bwyogatama/DC-Motor-Positioning-Control-System-Using-Arduino-Microcontroller/Schematic.png

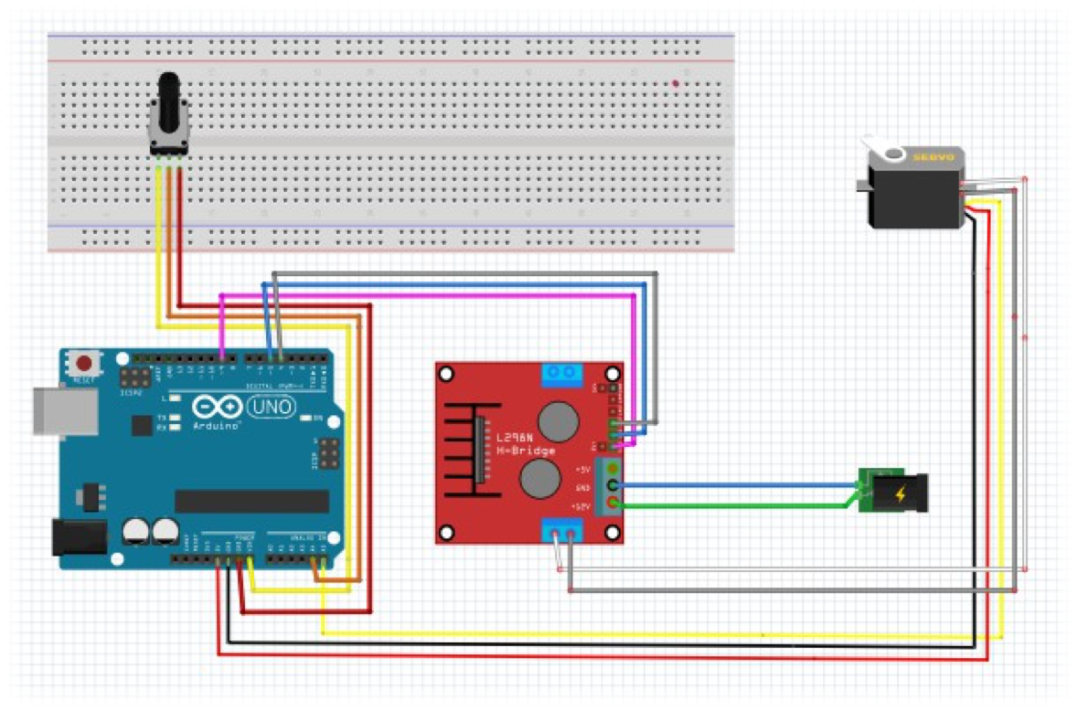
Schematic.png
