bwyogatama/DC-Motor-Positioning-Control-System-Using-Arduino-Microcontroller/Implementation1.png

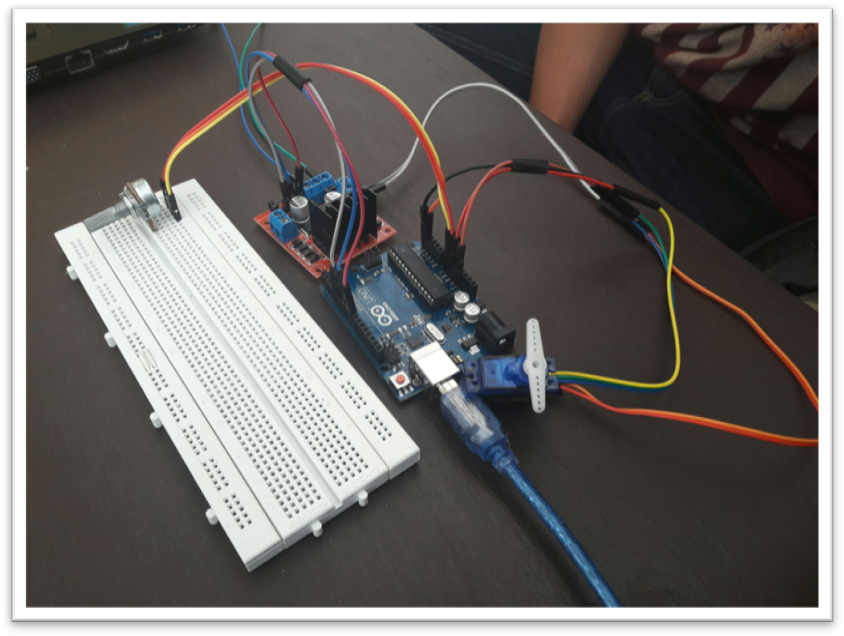
Implementation1.png
