bwyogatama/DC-Motor-Positioning-Control-System-Using-Arduino-Microcontroller/README.md

# DC-Motor-Positioning-Control-System-Using-Arduino-Microcontroller
