bwyogatama/DC-Motor-Positioning-Control-System-Using-Arduino-Microcontroller/Implementation2.png

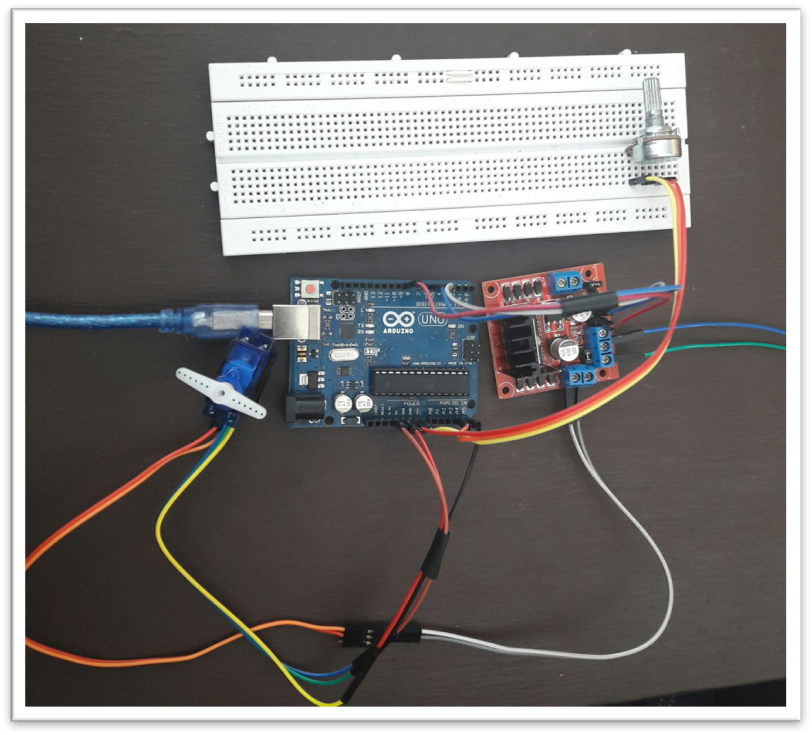
Implementation2.png
