bwyogatama/DC-Motor-Positioning-Control-System-Using-Arduino-Microcontroller/Testing Result/PD_Controller.png

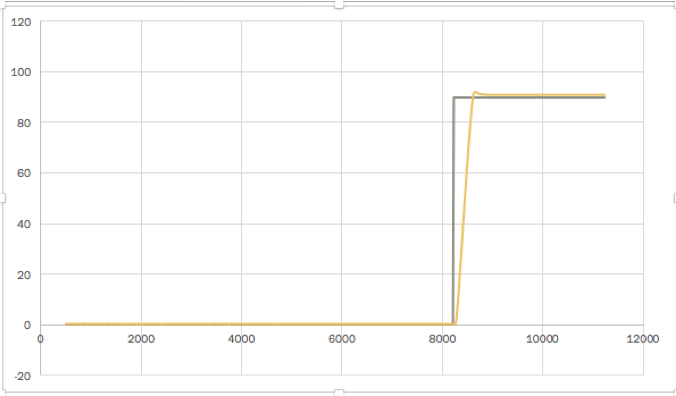
Testing Result/PD_Controller.png
