bwyogatama/DC-Motor-Positioning-Control-System-Using-Arduino-Microcontroller/Testing Result/PI_Controller.png

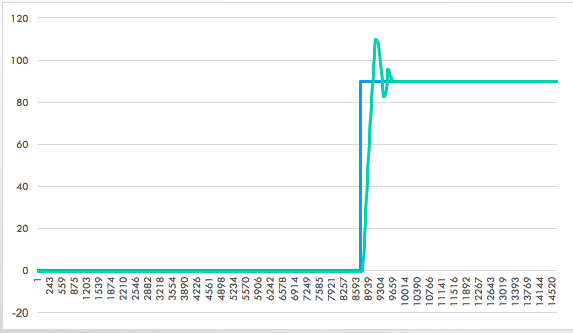
Testing Result/PI_Controller.png
