bwyogatama/DC-Motor-Positioning-Control-System-Using-Arduino-Microcontroller/Testing Result/Without_Controller.png

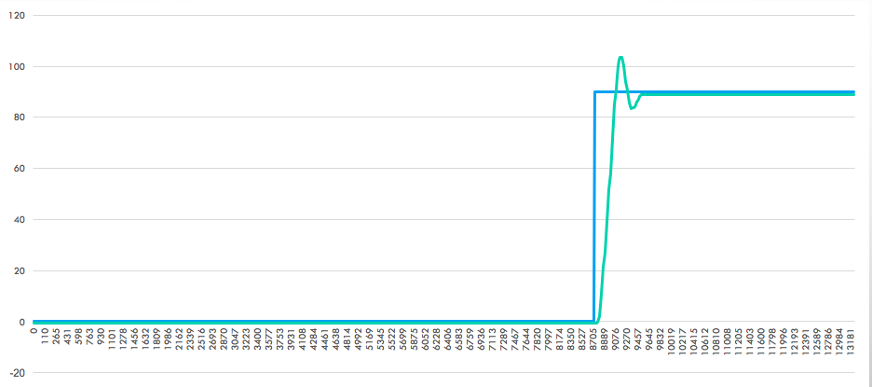
Testing Result/Without_Controller.png
